jonasgishere30-sys/AltoidsGameboy/docs/images/wiring-diagram.png

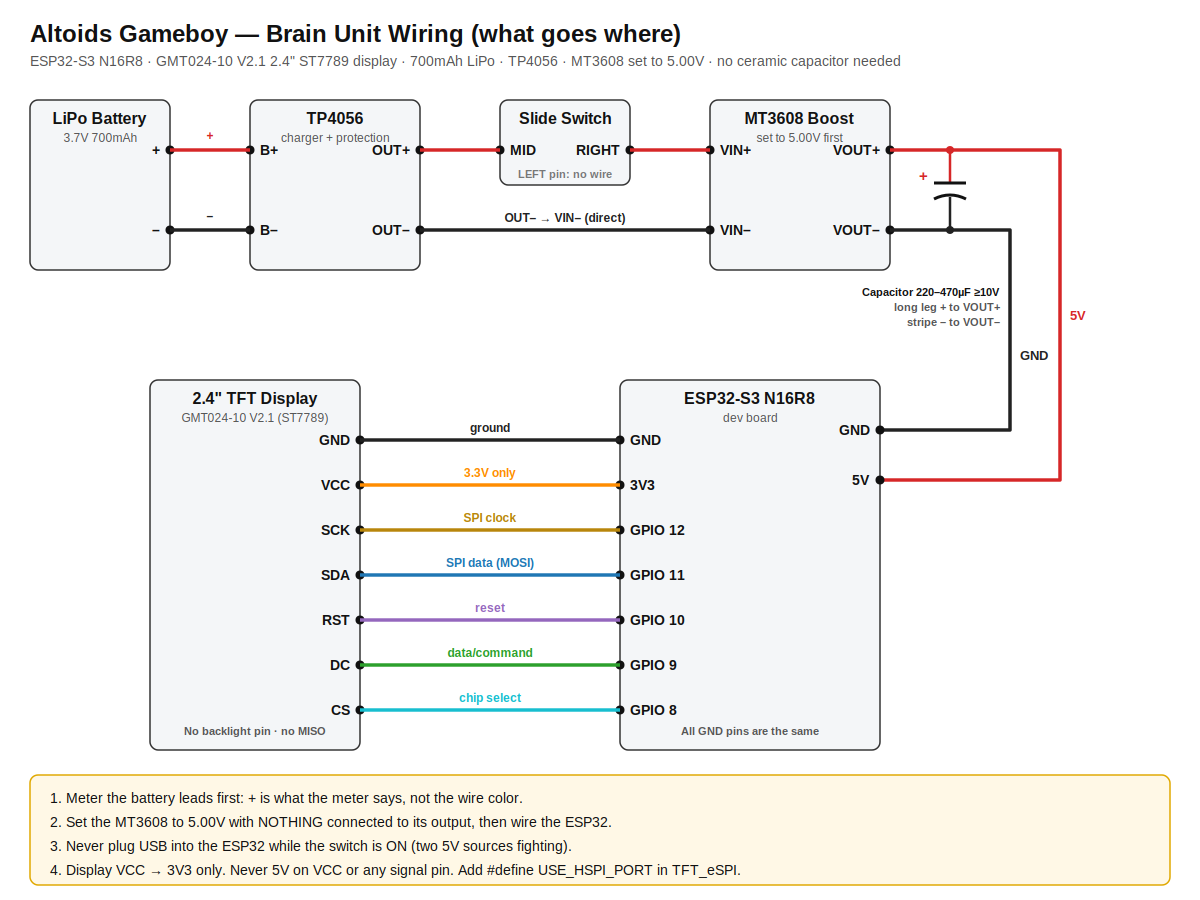
docs/images/wiring-diagram.png
