jonasgishere30-sys/AltoidsGameboy/(commit log)

2026-09-19 Create Unit-cardKB2 to ESP32-s3
    should print 000s and a number
2026-09-19 Create Brain, Screen, power
2026-09-22 Brain plan: add required USE_HSPI_PORT for ESP32-S3, verified display specs, charge-current warning, IDE settings
2026-09-22 Add full brain-unit wiring diagram; ceramic capacitor not required
2026-09-26 Add ScreenTest sketch (Adafruit ST7789, verified compiles on ESP32 core 3.3.12)
2026-09-26 Add KeyboardScreenTest: CardKB2 BLE keys shown on ST7789 (compiles on ESP32 core 3.3.12, NimBLE 2.5.1)
2026-09-26 Add single-file version of Arcade OS (paste into any sketch); types reordered for Arduino prototype generation
2026-09-26 Clean up repo: single firmware file (rotation fixed), docs/, tests/, archive/, README
    [AltoidsOS_OneFile.ino, CardKB2_FirstBLETest.ino, KeyboardScreenTest.ino, ScreenTest.ino]
2026-09-26 Arcade OS v1.5: replace 2048 with Turbo, a pseudo-3D racing game
    [AltoidsOS_OneFile.ino]
2026-09-26 Fix compile on ESP32 cores 3.0-3.3.x: use embedded root CAs instead of useBuiltinCACertBundle
    [AltoidsOS_OneFile.ino]
2026-10-01 Add project status doc (hardware, wiring, firmware v1.6)
